AmritAmar/TheHand/Pictures and Schematics/All Materials.jpg

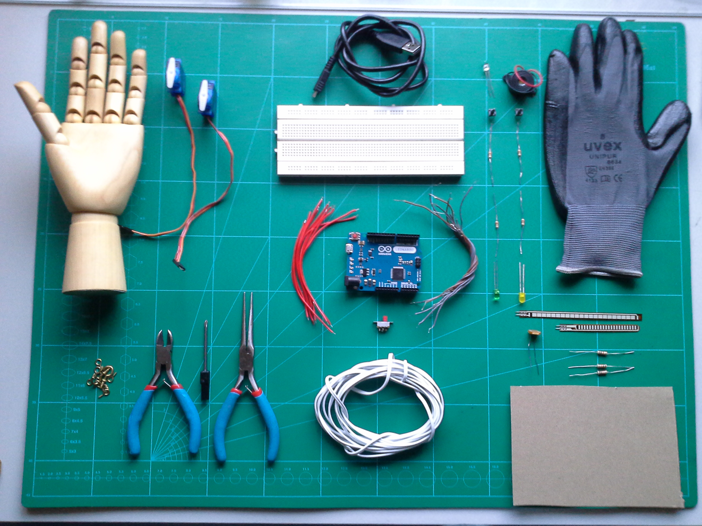
Pictures and Schematics/All Materials.jpg
