AmritAmar/TheHand/Pictures and Schematics/Servos.jpg

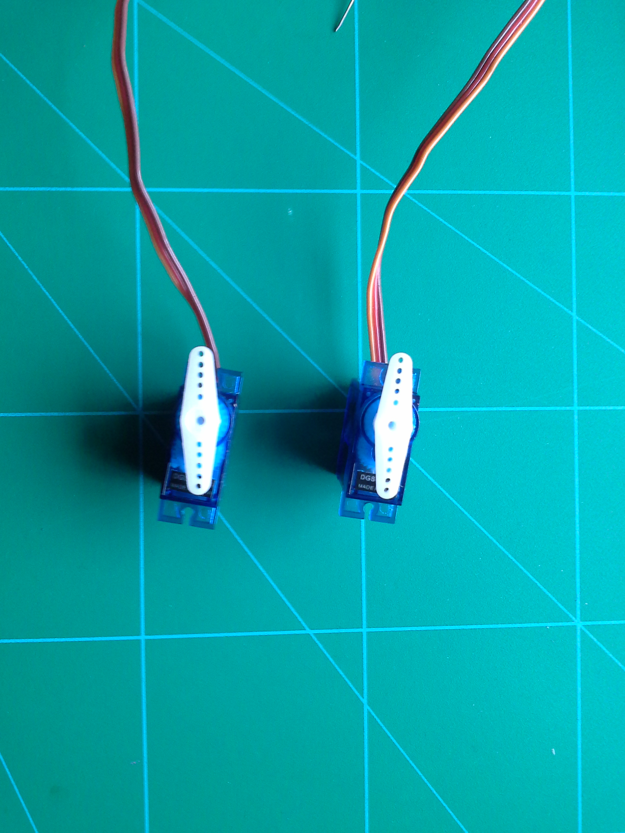
Pictures and Schematics/Servos.jpg
