AmritAmar/TheHand/Pictures and Schematics/Arduino.jpg

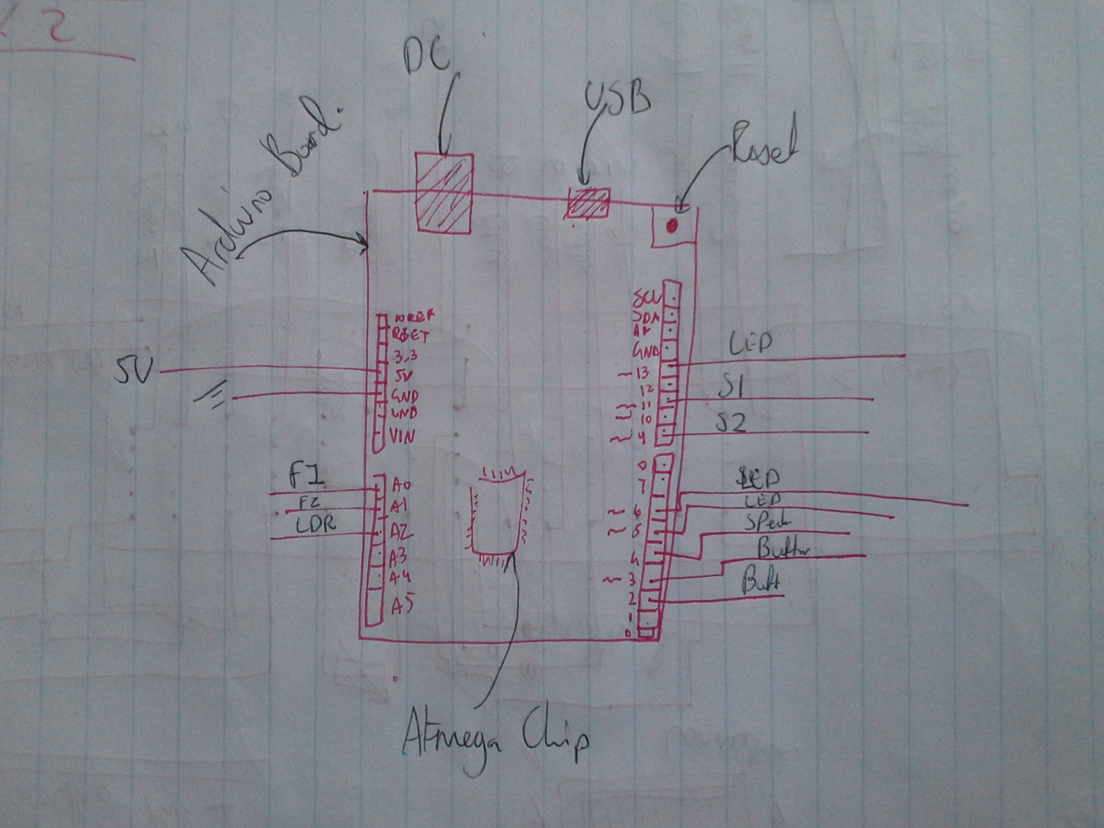
Pictures and Schematics/Arduino.jpg
