AmritAmar/TheHand/Pictures and Schematics/Capture1.PNG

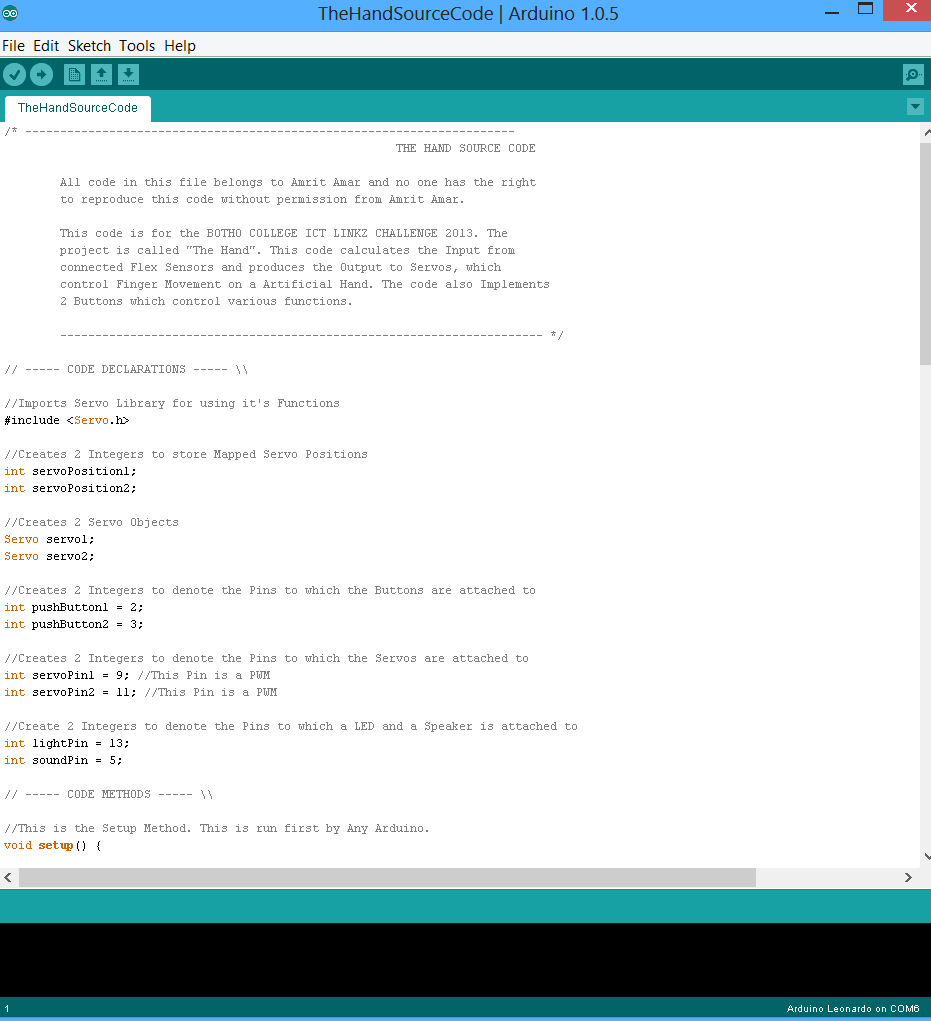
Pictures and Schematics/Capture1.PNG
