AmritAmar/TheHand/Pictures and Schematics/Capture2.PNG

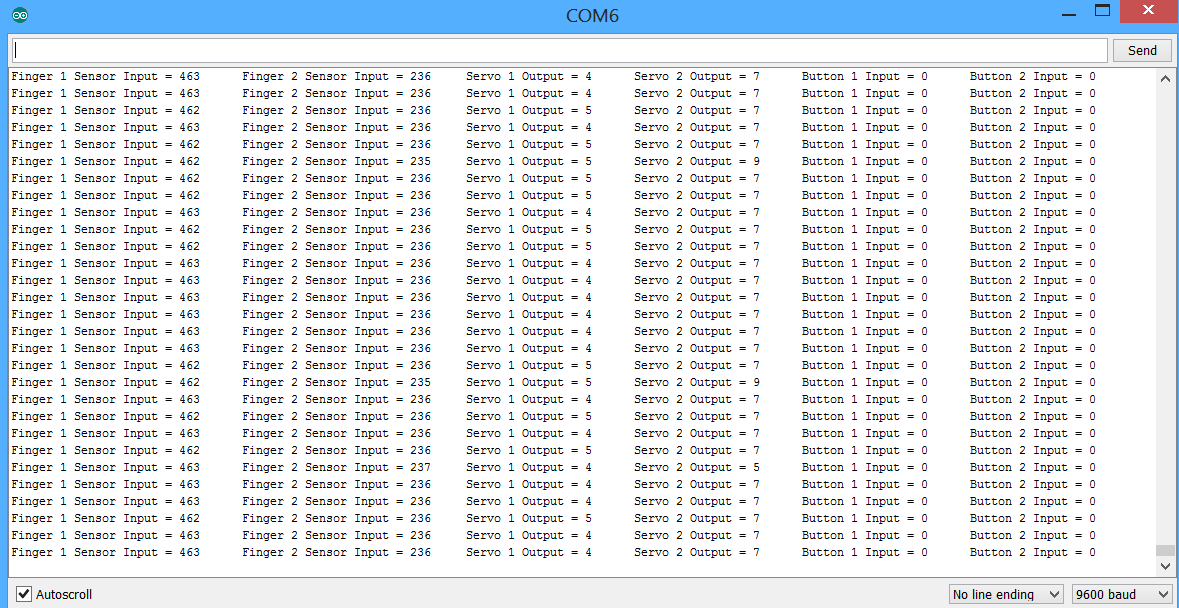
Pictures and Schematics/Capture2.PNG
