AmritAmar/TheHand/Pictures and Schematics/Connected.jpg

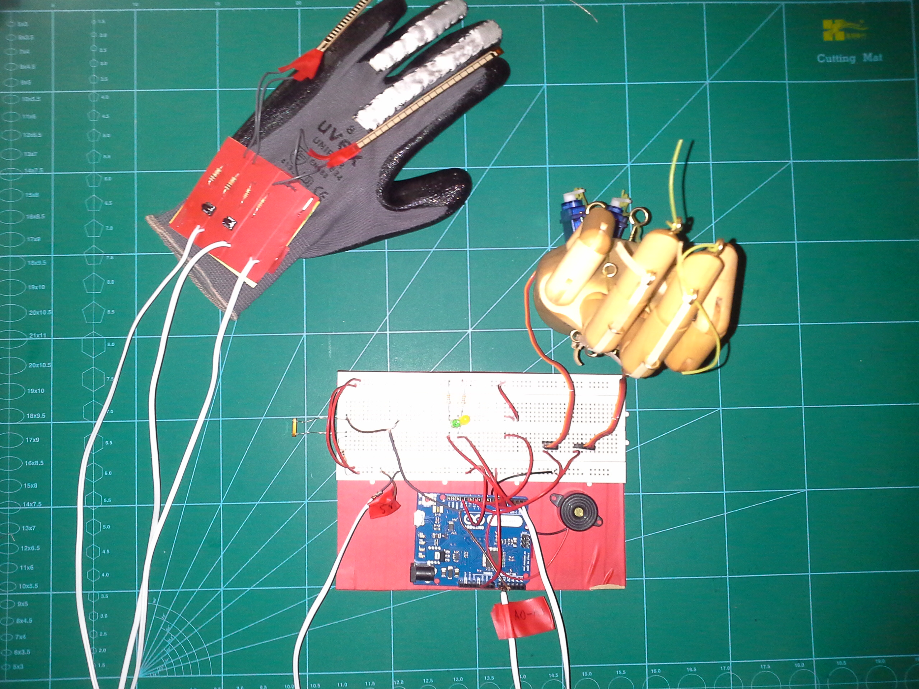
Pictures and Schematics/Connected.jpg
