AmritAmar/TheHand/Pictures and Schematics/Control Glove.jpg

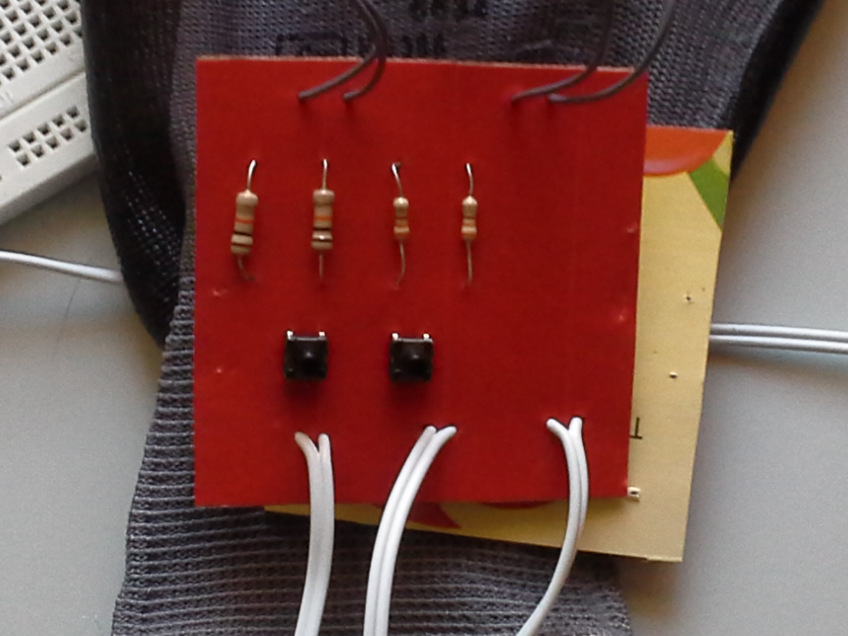
Pictures and Schematics/Control Glove.jpg
