AmritAmar/TheHand/Pictures and Schematics/Full Control Glove.jpg

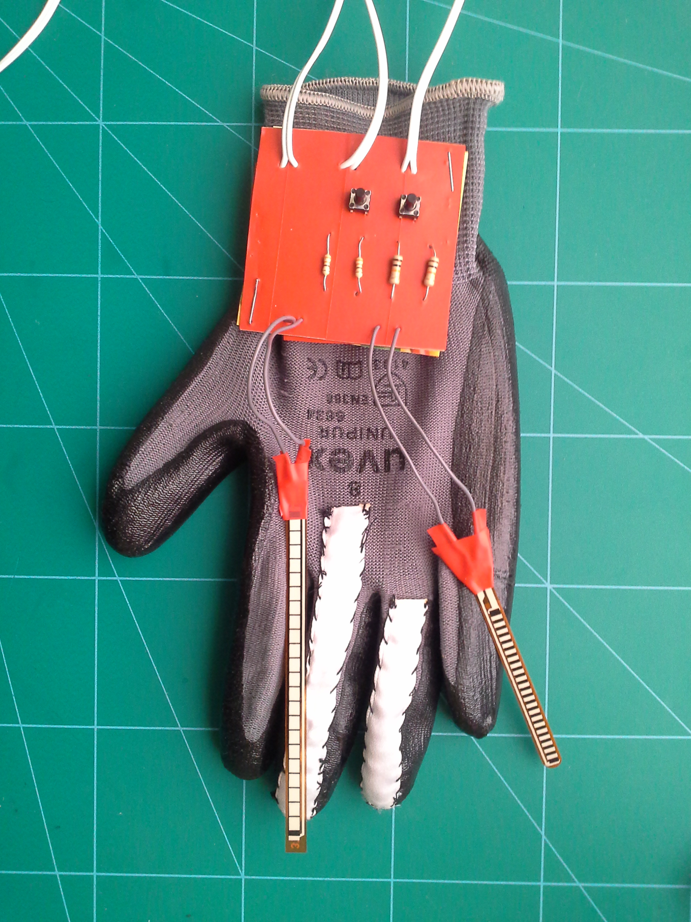
Pictures and Schematics/Full Control Glove.jpg
