AmritAmar/TheHand/Pictures and Schematics/In the process.jpg

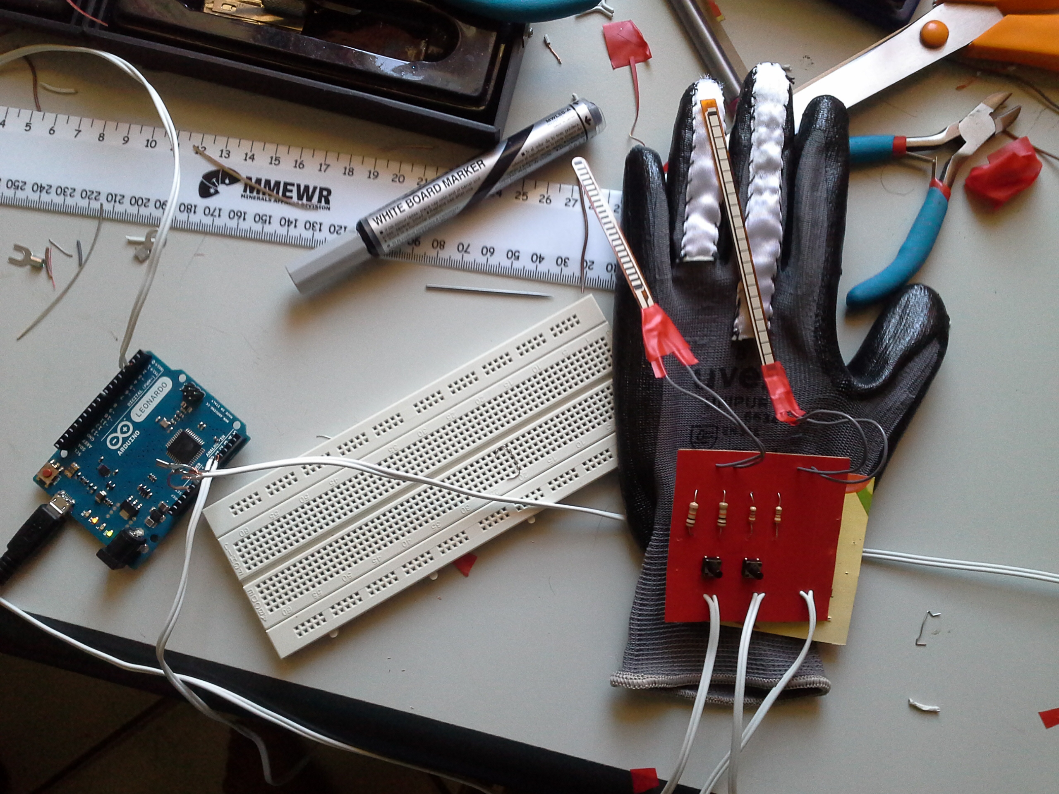
Pictures and Schematics/In the process.jpg
