AmritAmar/TheHand/Pictures and Schematics/The Hand Back.jpg

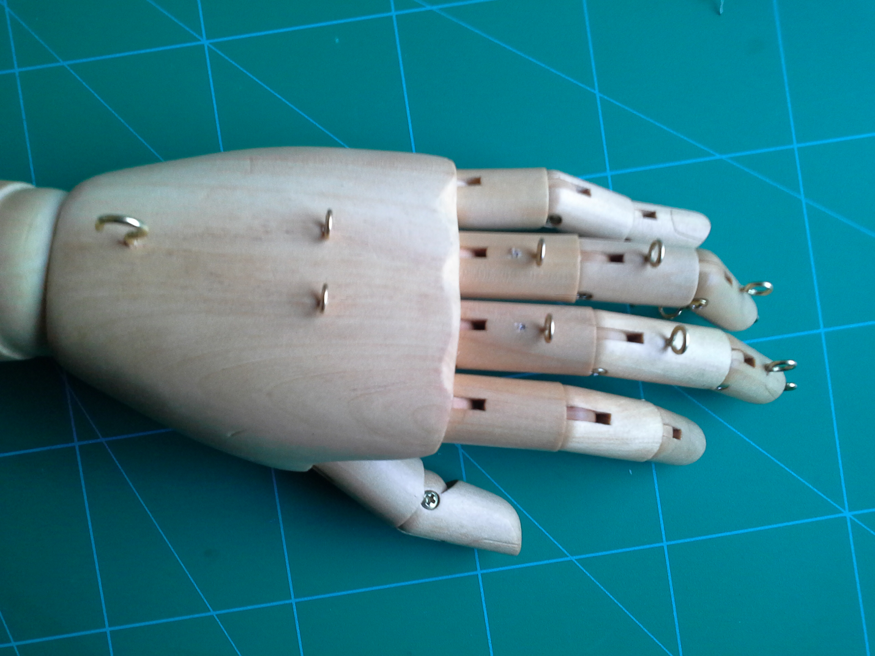
Pictures and Schematics/The Hand Back.jpg
