AmritAmar/TheHand/Pictures and Schematics/The Hand Front.jpg

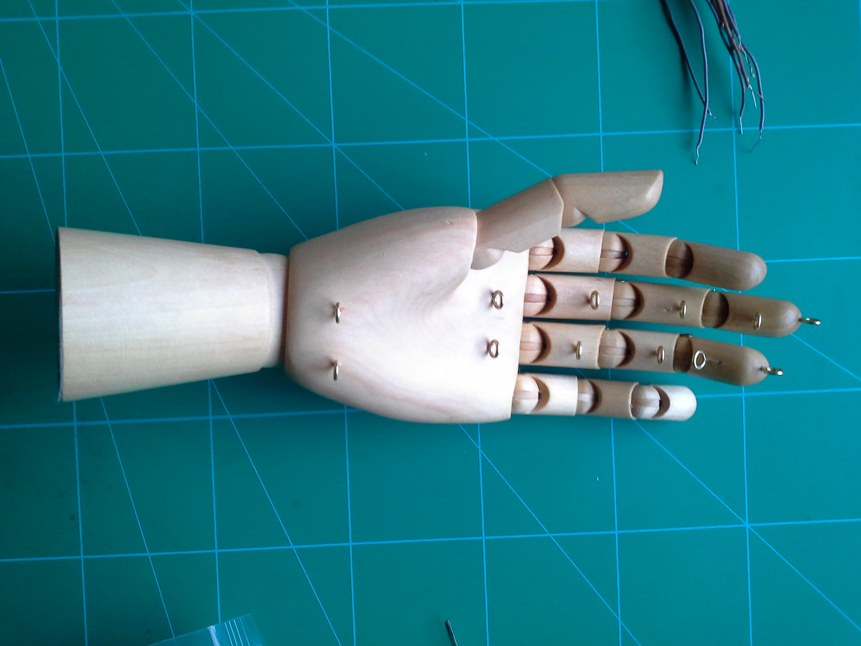
Pictures and Schematics/The Hand Front.jpg
