AmritAmar/TheHand/Pictures and Schematics/Breadboard Assembled.jpg

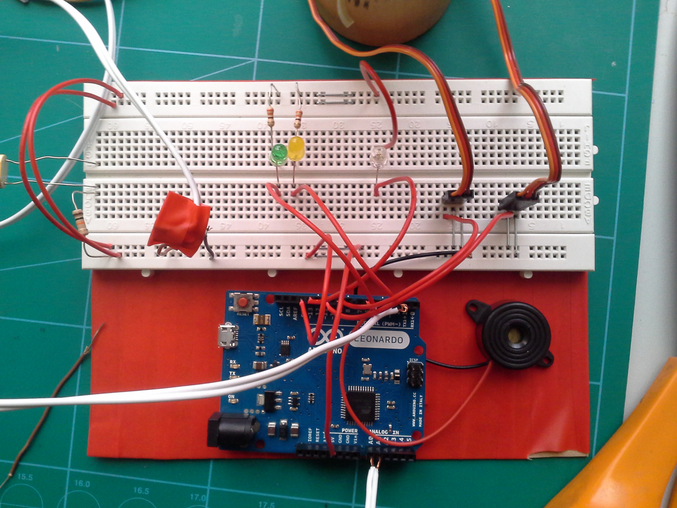
Pictures and Schematics/Breadboard Assembled.jpg
