AmritAmar/TheHand/Pictures and Schematics/Finger Test 1.jpg

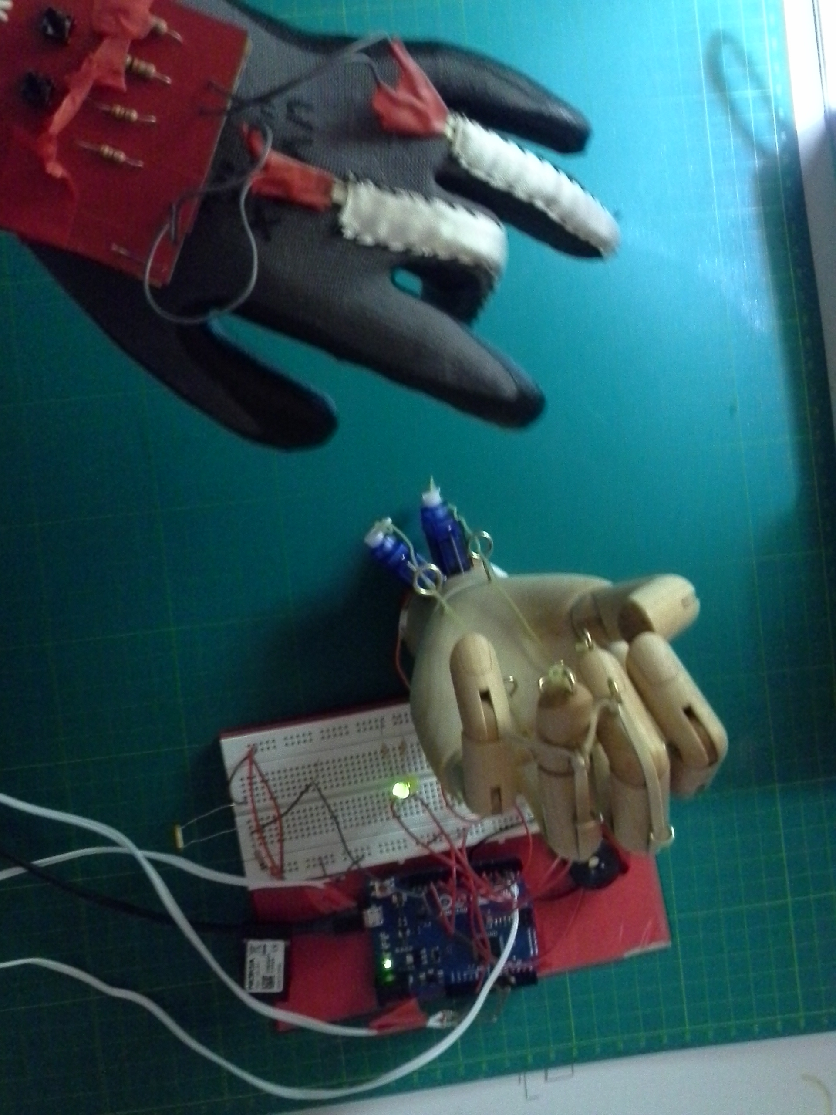
Pictures and Schematics/Finger Test 1.jpg
