AmritAmar/TheHand/Pictures and Schematics/Finger Test 2.jpg

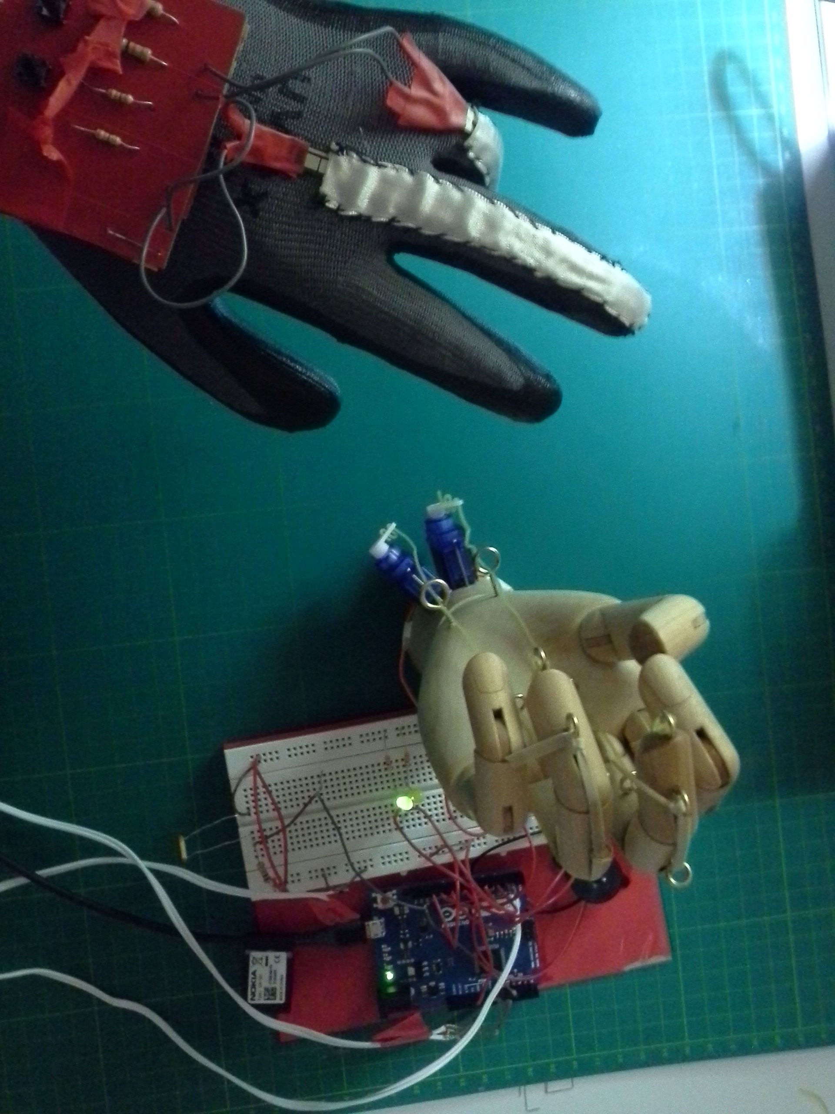
Pictures and Schematics/Finger Test 2.jpg
